Complicated128/CPE-301-Final-Project-Group-88/README.md

# Group 88's Final Project for CPE 301

This repository contains the code and all the reference materials that were used for assistance in the final project.

## Description

The final project is a physical swamp cooler. The swamp container contains these parts:

1. 3 Buttons (1 for start, stop, reset. 2 for stepper motor control)
2. Relays for Fan and Pump (2 SRD05VDC-SC-C)
3. Stepper Motor
4. LCD (LiquidCrystal Display)
5. Analog Water Sensor
6. DS1307 (External Clock)
7. DHT11 (Temperature Sensor)
8. ATMega2560
9. 12V 40CFM DC Blowerfan
10. Peristaltic Motor

## Circuit Details

<details>
<summary>3 Buttons (1 for start, stop, reset. 2 for stepper motor)</summary>
<br>
One button is used to control the entire circuit. It can start, stop, and reset.

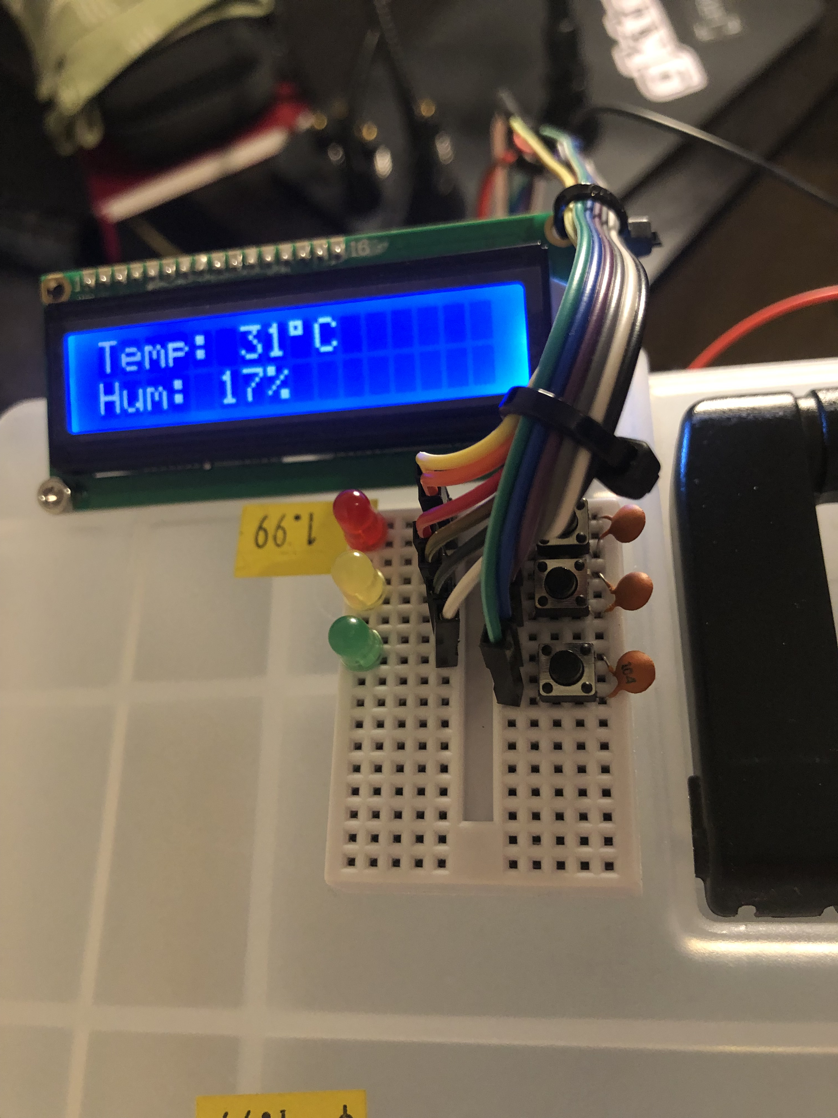
[picture p1: extras/circuitPhotos/wiring_IO.JPG]
image of circuit


The bottom button is used to control all of the states that it can (DISABLED, IDLE). The upper two buttons are stepper motor controls to turn either clockwise or counterclockwise.

</details>

<details>
<summary>Relays for Fan and Pump (2 SRD05VDC-SC-C)</summary>
<br>
We used relays to help simplify the control of fans and pumps. They are the red rectangles.

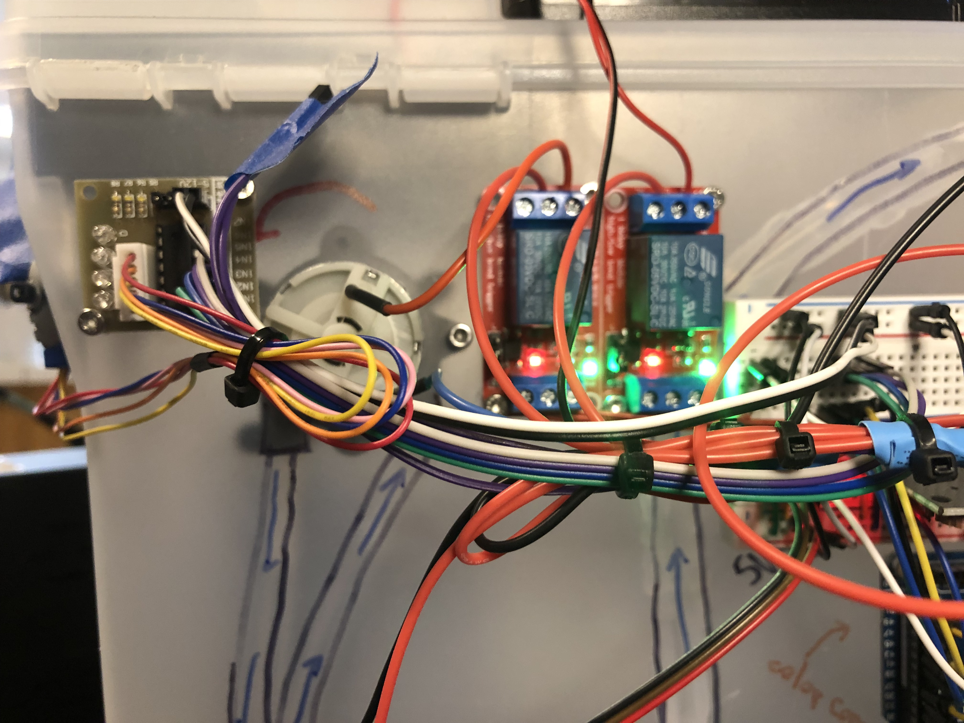
[picture p2: extras/circuitPhotos/wiring_control.JPG]
image of circuit


</details>

<details>
<summary>Stepper Motor</summary>
<br>
Stepper motor is used to adjust vent. It is to the left of the picture.

image of circuit

</details>

<details>
<summary>LCD (LiquidCrystal Display)</summary>
<br>
LCD is used to help display useful information. It is the big display.

image of circuit

</details>

<details>
<summary>Analog Water Sensor</summary>
<br>
It is used to measure how much water is inside the swamp cooler. It is on the bottom of the picture.

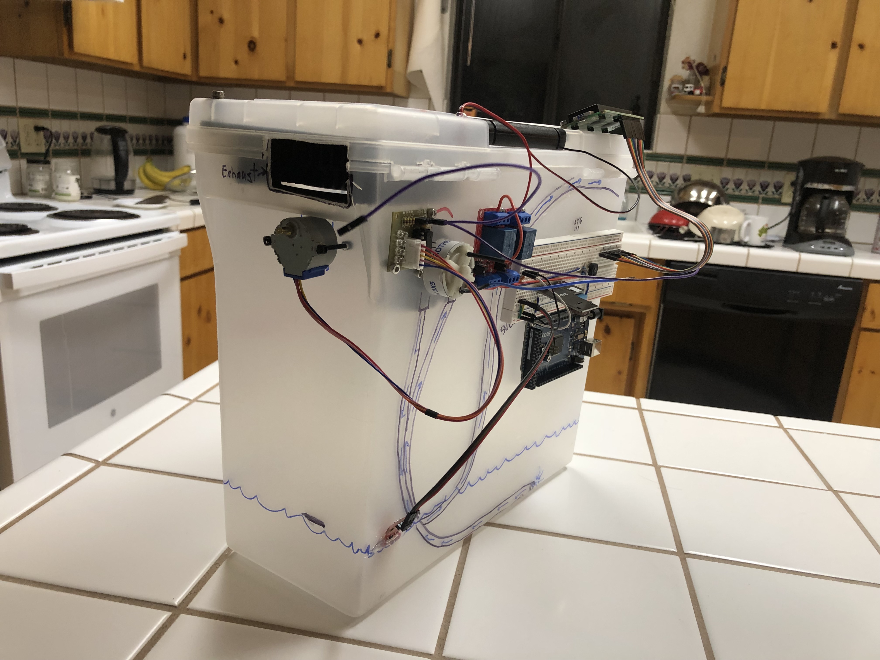
[picture p3: extras/buildPhotos/2_stepper_and_watersensor.JPG]


</details>

<details>
<summary>DS1307 (External Clock)</summary>
<br>
It is used to print accurate timestamps. It is in the middle of the white breadboard.

image of circuit


</details>

<details>
<summary>DS1307 (External Clock/RTC)</summary>
<br>
It is used to print accurate timestamps. It is in the middle of the white breadboard.

image of circuit

</details>

<details>
<summary>DHT11 (Temperature Sensor)</summary>
<br>
It is used to measure temperature and humidity. It is above the RTC.

image of circuit

</details>

<details>
<summary>ATMega2560</summary>
<br>
It is used to control the whole circuit. It is underneath the breadboard.

image of circuit

</details>

<details>
<summary>12V 40CFM DC Blowerfan</summary>
<br>
It is used to take in heat and dump it outside. It is the black thing with a rectangular shape.

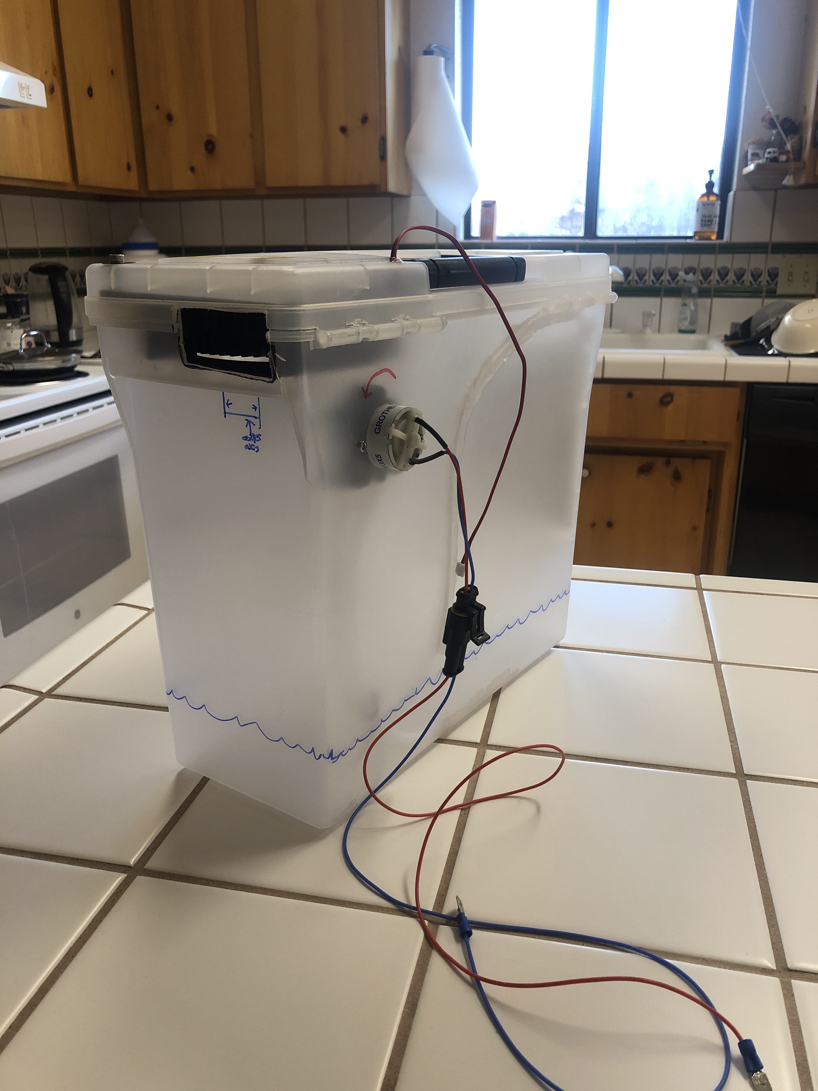
[picture p5: extras/buildPhotos/1_fanexhaust.jpg]


</details>

<details>
<summary>Peristaltic Motor</summary>
<br>
It is used to pump water to the cooler pad. It can be found underneat the Blowerfan.

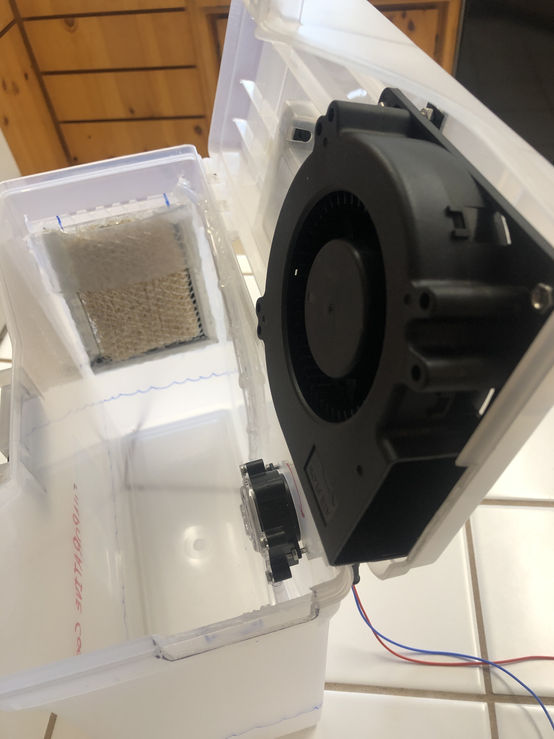
[picture p6: extras/buildPhotos/1_insideinprogress.jpg]


</details>

## Schematic Diagram

<details>
<summary>The diagram in question</summary>
<br>

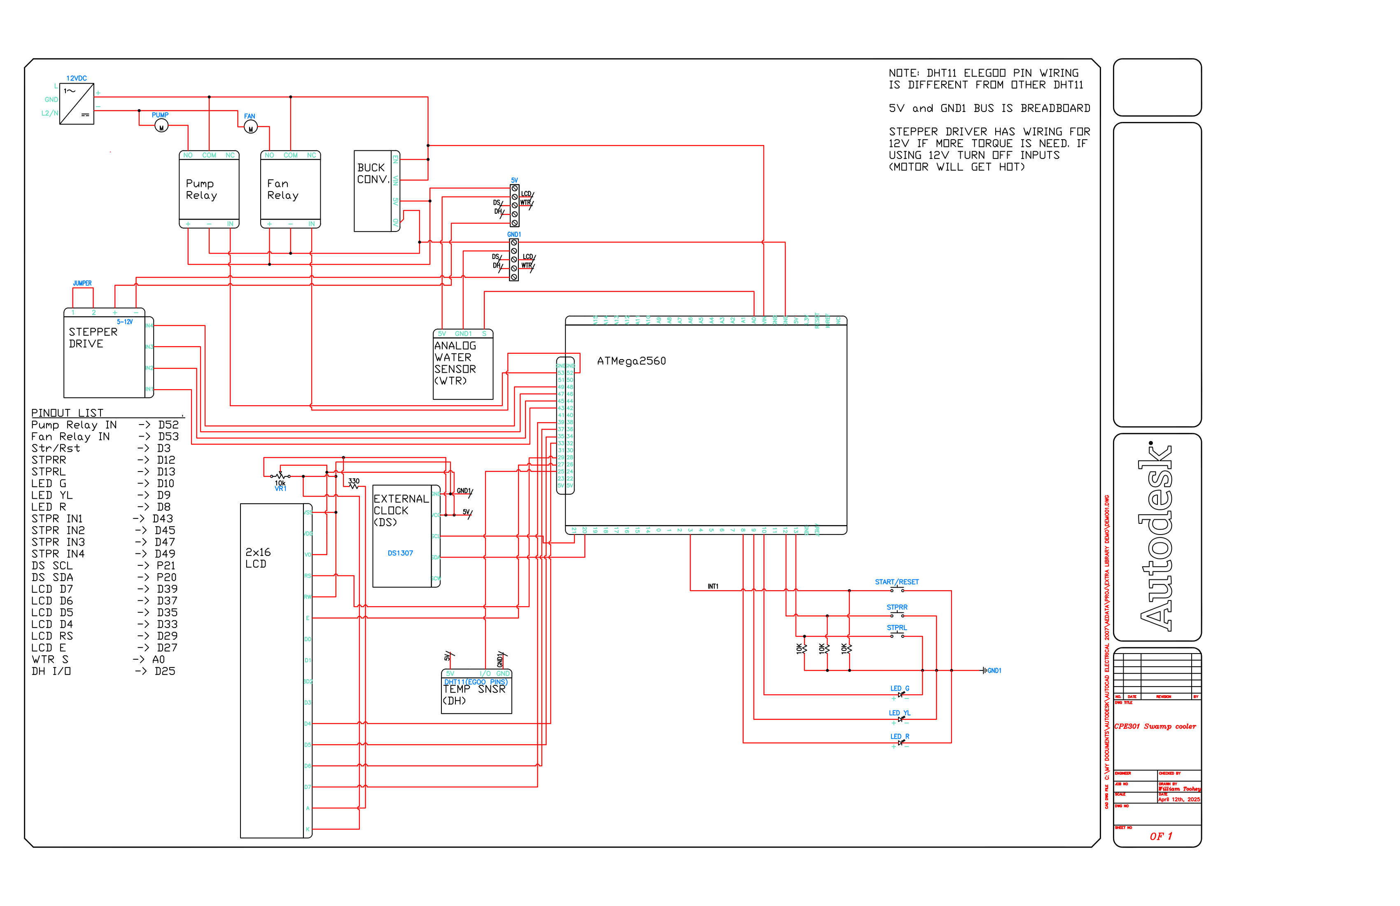
[picture p7: extras/cpe301finalwiringdiagram-1.png]


</details>

## System Demonstration

video of a swamp cooler project demonstration (https://www.youtube.com/watch?v=Vm3F59e2kbA)
Clicking upon this will redirect you to this link: https://www.youtube.com/watch?v=Vm3F59e2kbA

## Team Members
The team consists of the burnt out students: Aaron Ba, William Toohey, Sean Lai

All credit of the physical circuitry goes to William Toohey, along with some of the code. Aaron Ba and Sean Lai revamped the code.

## Extra Stuff

Check out the "extras" folder as it has many more photos of the circuit, and the physical build.

It also includes the final report(s) and the wiring diagram. 

### Deviations from the given diagrams
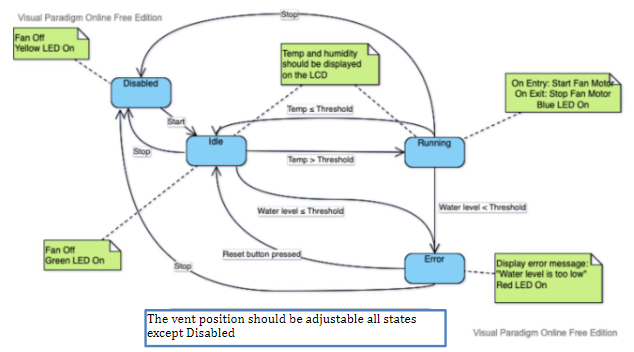
[picture p8: extras/imageOrig.png]


versus

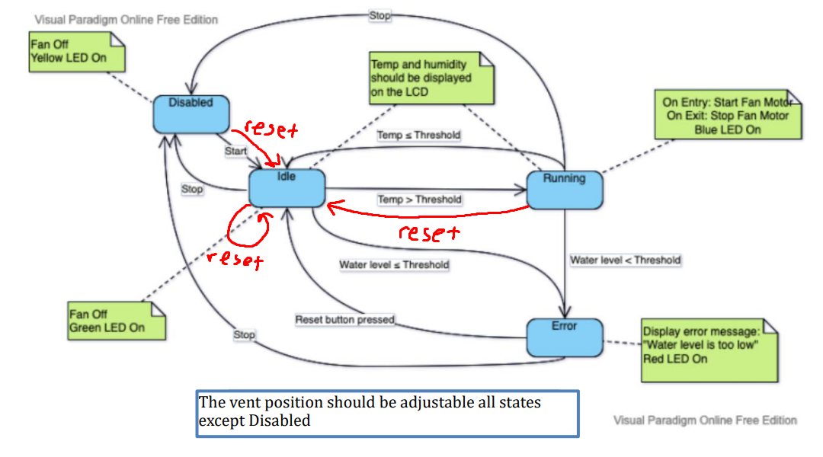
[picture p9: extras/imageReset.png]


To us, this makes more sense because why would reset only work for ERROR?
We made it so that everytime we hold the button (holding triggers reset), it will do the setup again and pretend it started at the very beginning.
