Complicated128/CPE-301-Final-Project-Group-88/extras/CPE301Final Report.pdf

# CPE301 Group 88: Swamp Cooler

CPE 301 Embedded System Design - University of Nevada, Reno

## 1. Project Description

This project implements an evaporative cooling system (swamp cooler) using the ATmega2560 microcontroller. The project consists of all the components found in teSystem monitors temperature and humidity levels, controls a fan motor based on temperature thresholds, monitors water levels, provides user controls for system operation and vent adjustment, and logs state transitions to a host computer. The implementation uses register-level programming for most functionality, avoiding high-level Arduino functions like pinMode() and digitalWrite() as specified in the requirements.

## 2. Component Details

Microcontroller

- ATmega2560: The primary controller.

Sensors

- DHT11 Temperature and Humidity Sensor: Connected to the microcontroller to monitor ambient temperature and humidity.The sensor values are read through pins SCL and SDA using serial communications, with data displayed on the LCD during the RUNNING or IDLE state.
- Water Level Sensor: Used to monitor the reservoir water level. Implemented using direct ADC sampling without the Arduino ADC library. When water levels fall below threshold, the system enters the ERROR state, this ERROR state must then be clear and the sensor value will be reread to determine the machine state.

Actuators

- GPU Fan: Repurposed for primary air circulation it provides ~40cfm at 12VDC, controlled by a separate power supply board to prevent damage to the Arduino and controlled using a SRD-05VDC relay breakout board with optocouplers, flyback diodes and transistors. The fan logic is determined by temperature readings and the current state through direct register manipulation.
- Stepper Motor: Used to simulate the use of a vent to directionally control the airflow or restrict airflow out of the exhaust. The vent is adjusted using push buttons on the top of the cooler adjustable by the user through a potentiometer. The Arduino stepper library was used to position the stepper motor.
- Peristaltic Pump: 12V peristaltic pump with .25” vinyl tubing to circulate water through the system. The pump is controlled using a SRD-05VDC relay breakout board with optocouplers, flyback diodes, and transistors.

User Interface

- LCD Display: Shows current temperature, humidity, during the IDLE or RUNNING state.
- LEDs: Indicate system status:
- Yellow LED: Indicates DISABLED state
- Green LED: Indicates IDLE state
- Blue LED: Indicates RUNNING state
- Red LED: Indicates ERROR state
- Control Button: Performs 3 distinct operations depending on system state using ISR()
- DISABLED -> IDLE if no errors exist.
- RUNNING -> DISABLED turns off fan and pump.
- ERROR -> IDLE/RUNNING user must hold button for 3 seconds to clear error.

Additional Components

- Peristaltic Pump: Circulates water through the system
- Relays: Control power to the fan and water pump.
- Evaporative Cooling Pads: Provide the wet surface for air evaporation cooling.
- File Cabinet Box: Housing.
- 12V GPU Blower Fan: Circulate air through the housing.
- Capacitors: Various capacitor values were implemented to eliminate the need for debouncing logic in the code. Also used to damped initial voltage drop that may be seen from the power supply to the buck converter when transition to RUNNING state.
- 19V->5V 2A Buck Converter: Converter to step down a regulated voltage from 12VDC to 5VDC.

## 3. System Overview

Swamp cooler operates as a finite state machine with four states:

1. DISABLED State:
- Yellow LED on
- No temperature or water level monitoring
- System responds only to the Start button (via ISR)
- Vent control disabled
2. IDLE State:
- Green LED on
- Continuous temperature, humidity, and water level monitoring

- Fan off
- Transitions to RUNNING when temperature exceeds threshold
- Transitions to ERROR if water level is too low
- Transitions to DISABLED if Stop button pressed
- Vent position adjustable
3. RUNNING State:
- Blue LED on
- Fan motor on
- Continuous monitoring of temperature, humidity, and water level
- Transitions to IDLE when temperature falls below threshold
- Transitions to ERROR if water level is too low
- Transitions to DISABLED if Stop button pressed
- Vent position adjustable
4. ERROR State:
- Red LED on
- Fan motor off
- Error message displayed on LCD ("Water level is too low")
- Transitions to IDLE if Reset button held for 3 seconds and water level is sufficient

The system operates within the following constraints:

- 12V 1.5A (21V 2A MAX)

## 4. Circuit Image

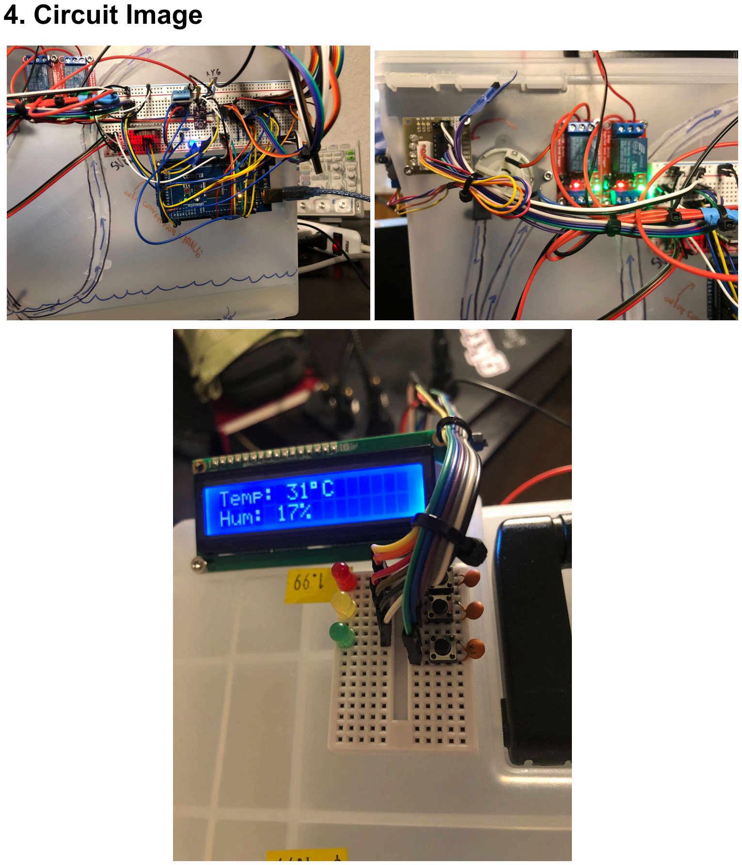
[picture p10: page 4]

## 5. Schematic Diagram

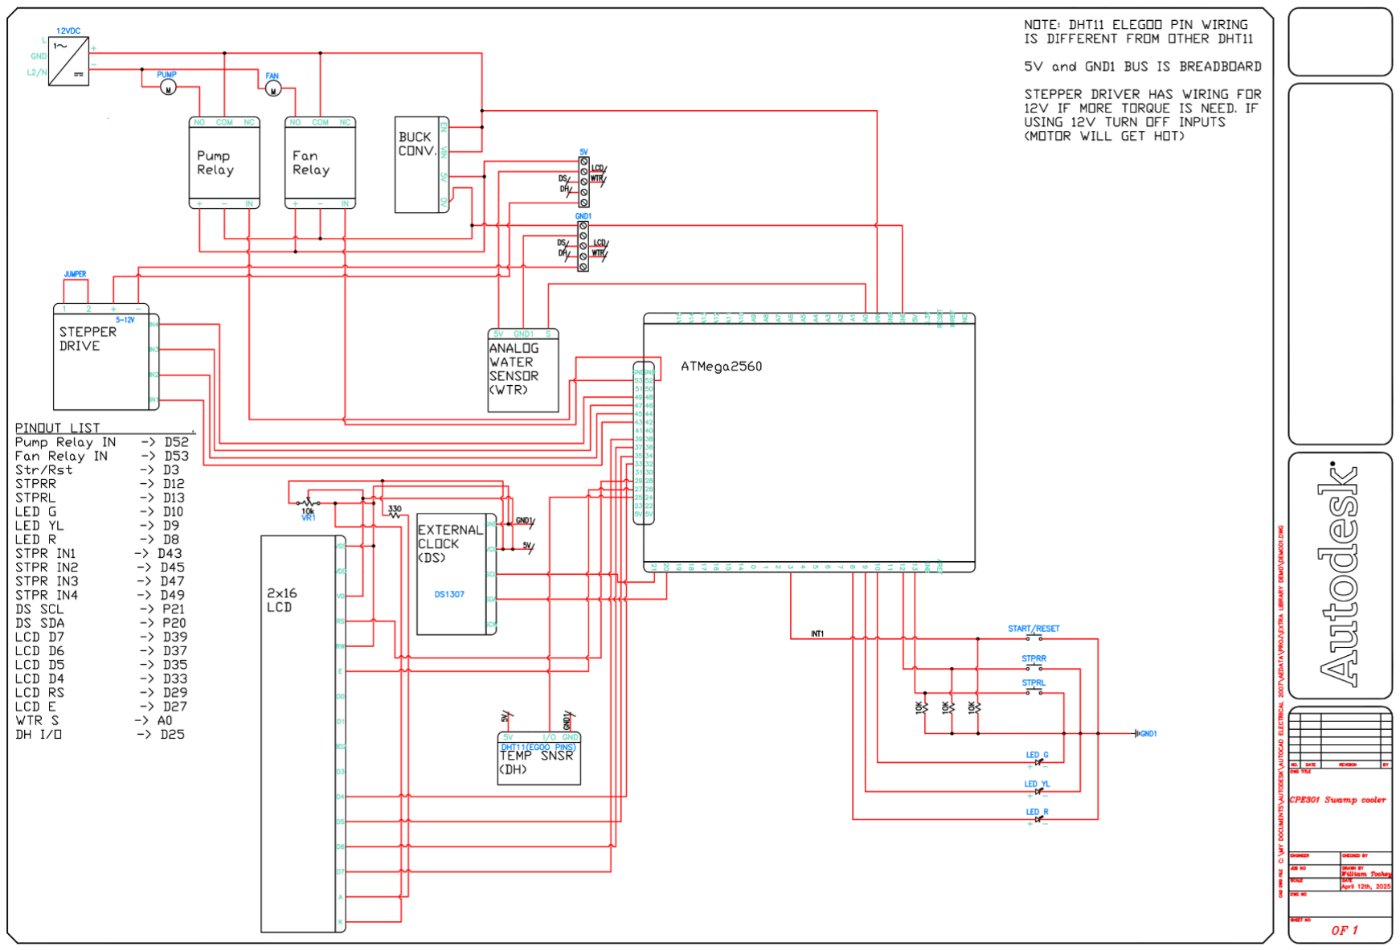
[picture p11: figure]

## 6. Demonstration

https://www.youtube.com/watch?v=Vm3F59e2kbA

## 7. Links

https://github.com/Complicated128/CPE-301-Final-Project-Group-88/blob/main/README.md
