Complicated128/CPE-301-Final-Project-Group-88/extras/buildPhotos/2_main_component_mounts.JPG

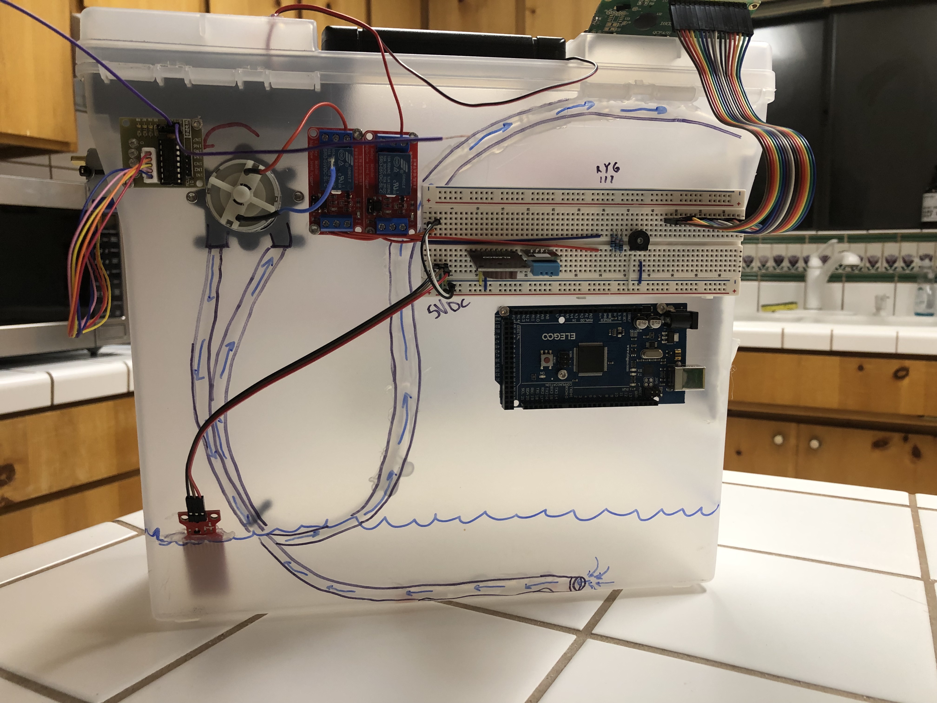
extras/buildPhotos/2_main_component_mounts.JPG
