Complicated128/CPE-301-Final-Project-Group-88/extras/buildPhotos/1_coolerpadtrough.jpg

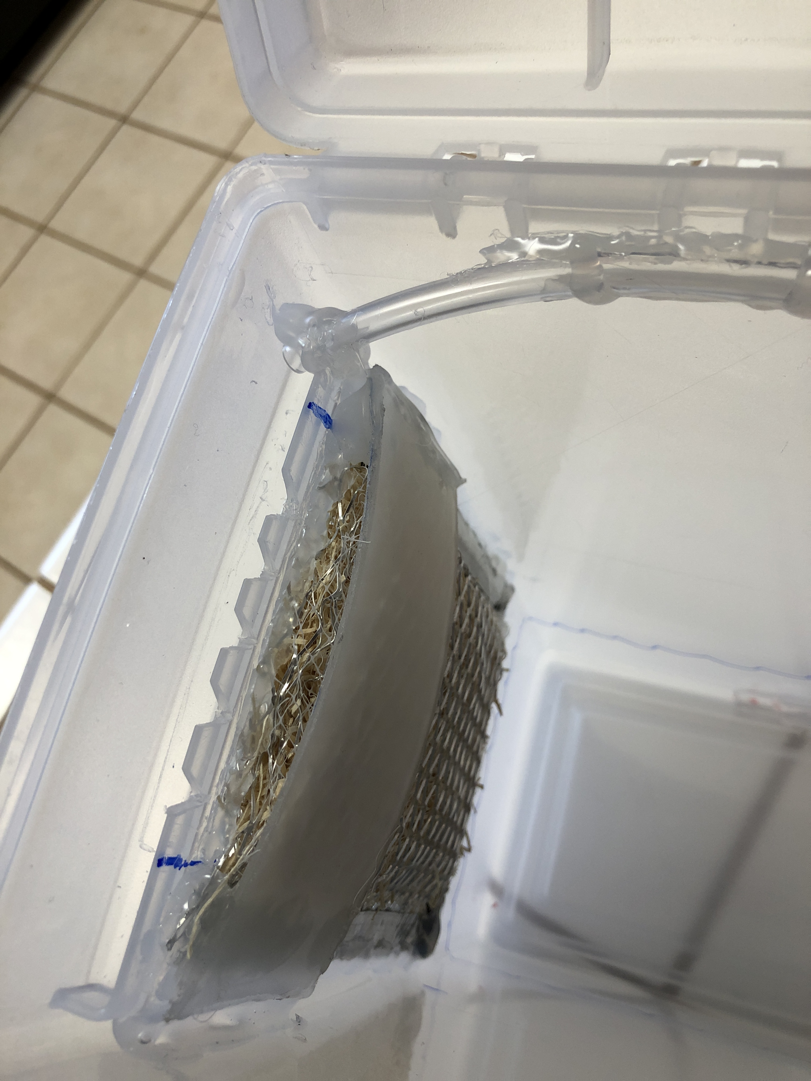
extras/buildPhotos/1_coolerpadtrough.jpg
