Complicated128/CPE-301-Final-Project-Group-88/extras/buildPhotos/2_lcdmount.JPG

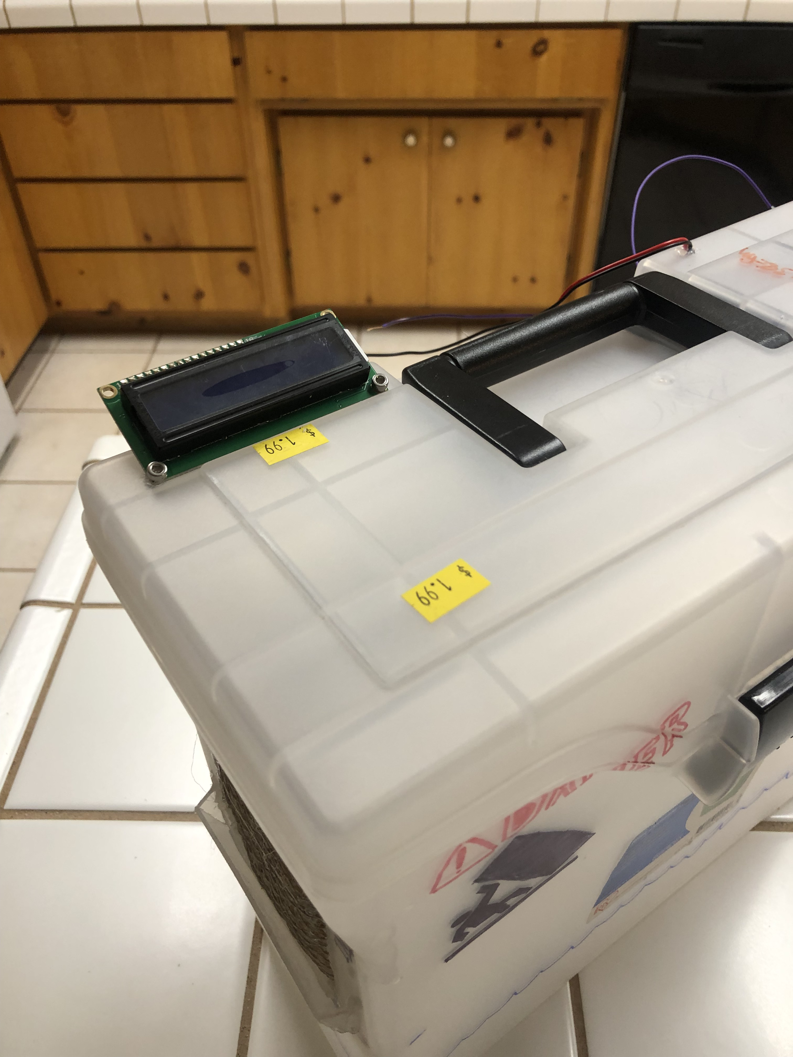
extras/buildPhotos/2_lcdmount.JPG
