Complicated128/CPE-301-Final-Project-Group-88/extras/buildPhotos/3_wiring.JPG

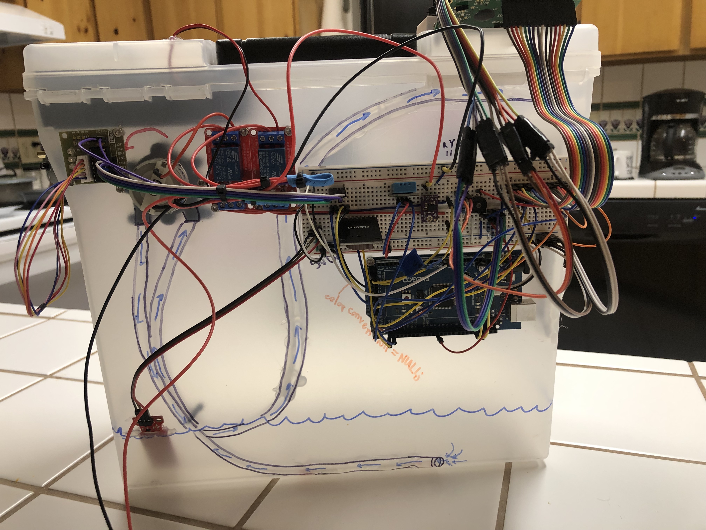
extras/buildPhotos/3_wiring.JPG
