Complicated128/CPE-301-Final-Project-Group-88/extras/buildPhotos/running.JPG

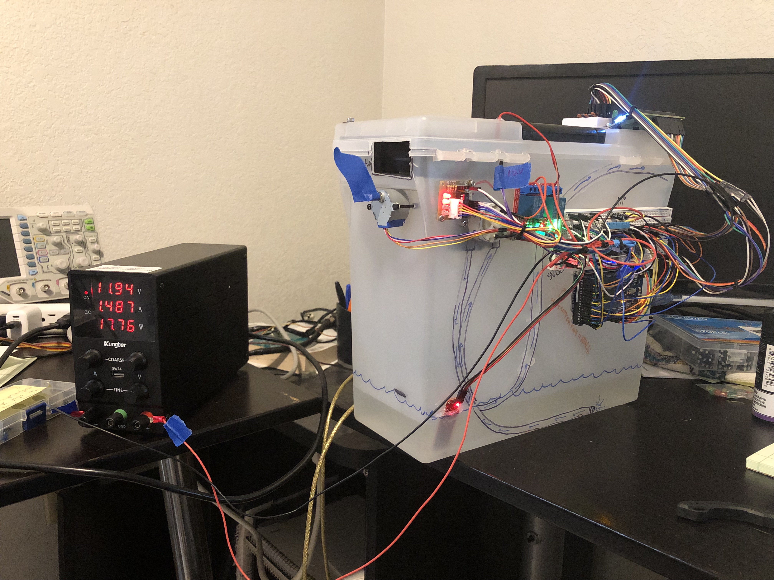
extras/buildPhotos/running.JPG
