Complicated128/CPE-301-Final-Project-Group-88/extras/buildPhotos/running_face.JPG

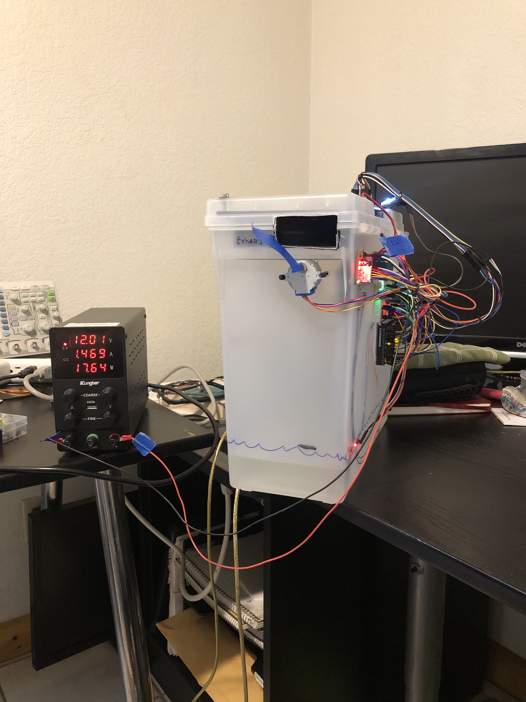
extras/buildPhotos/running_face.JPG
