Complicated128/CPE-301-Final-Project-Group-88/extras/buildPhotos/runningtemps.JPG

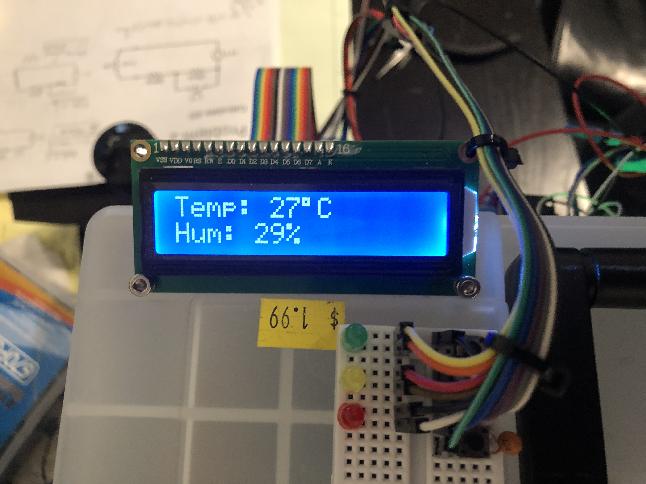
extras/buildPhotos/runningtemps.JPG
