Complicated128/CPE-301-Final-Project-Group-88/extras/buildPhotos/stepperboardbroken.JPG

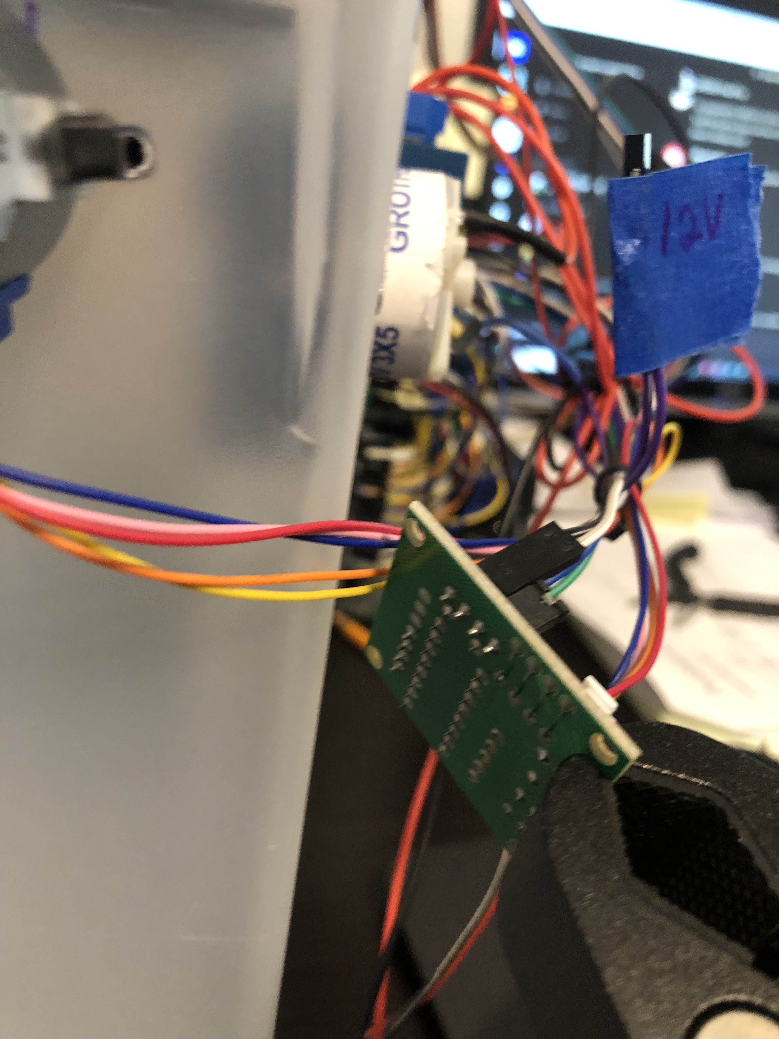
extras/buildPhotos/stepperboardbroken.JPG
