Complicated128/CPE-301-Final-Project-Group-88/extras/buildPhotos/steppermotorsupply.JPG

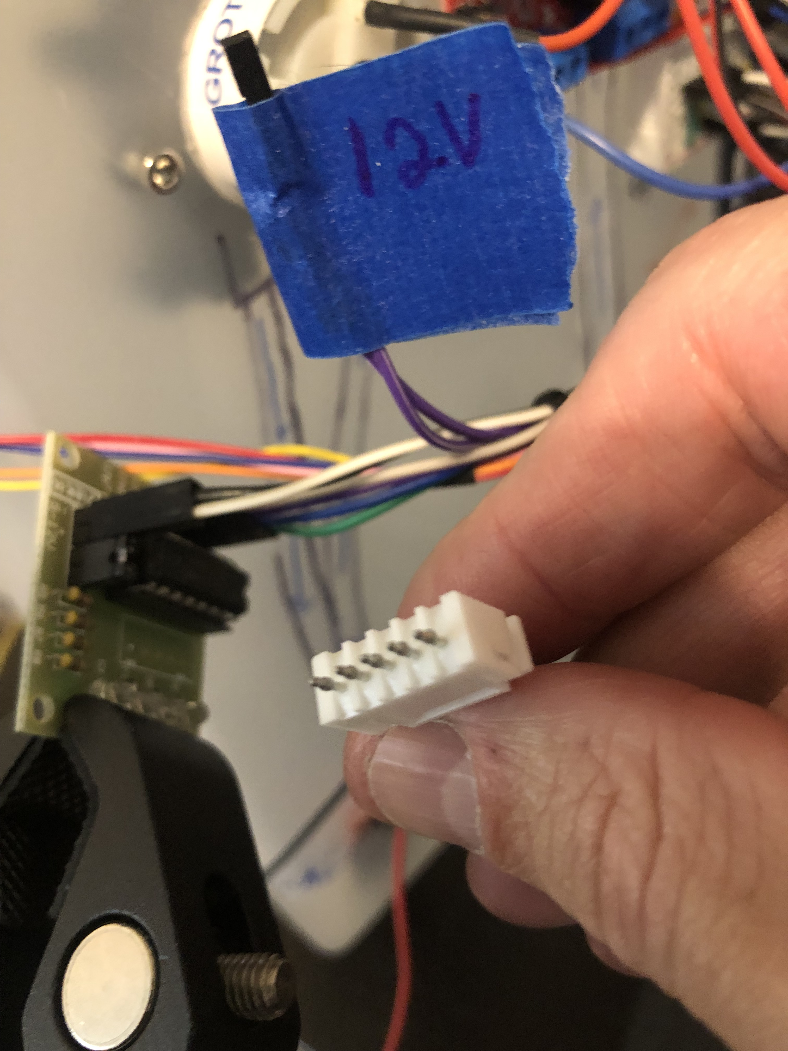
extras/buildPhotos/steppermotorsupply.JPG
