Complicated128/CPE-301-Final-Project-Group-88/extras/buildPhotos/stepperresoldered.JPG

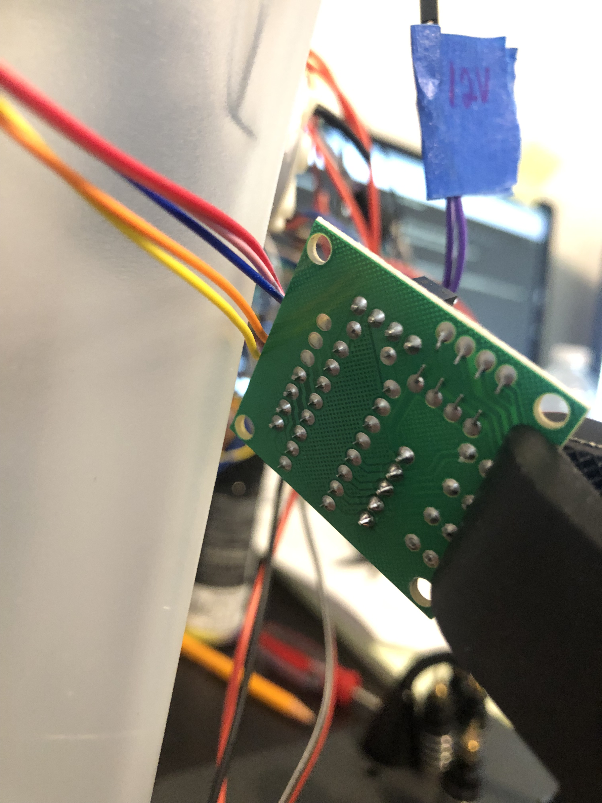
extras/buildPhotos/stepperresoldered.JPG
