Complicated128/CPE-301-Final-Project-Group-88/extras/buildPhotos/tempambientdesk.jpg

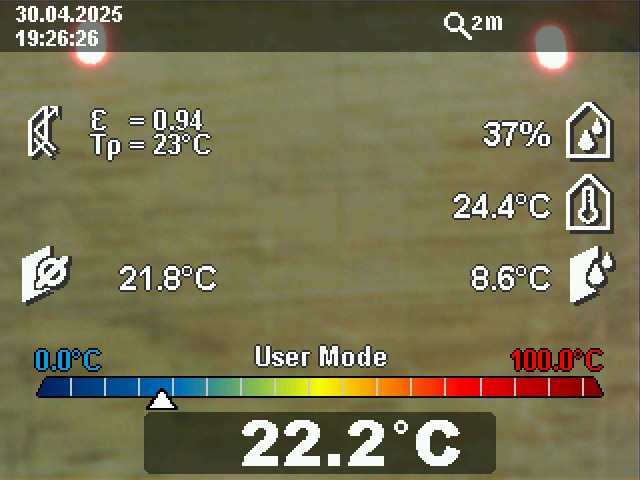
extras/buildPhotos/tempambientdesk.jpg
