Complicated128/CPE-301-Final-Project-Group-88/extras/buildPhotos/tempcontainer.jpg

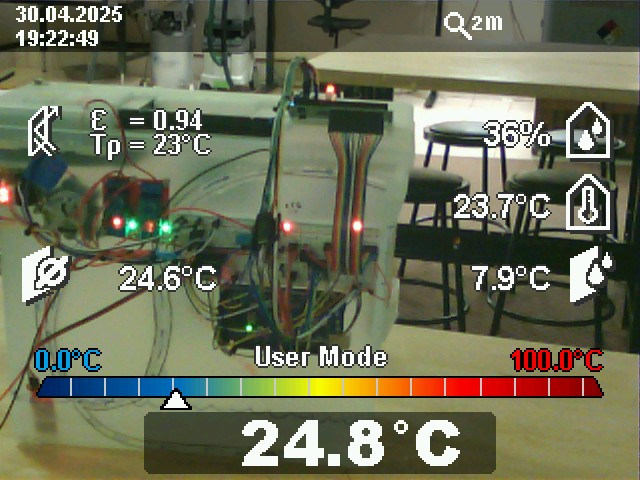
extras/buildPhotos/tempcontainer.jpg
