Complicated128/CPE-301-Final-Project-Group-88/extras/buildPhotos/tempexhaust.jpg

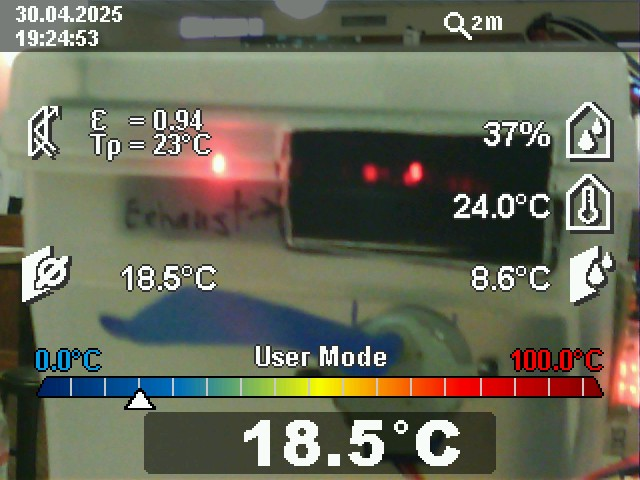
extras/buildPhotos/tempexhaust.jpg
