Complicated128/CPE-301-Final-Project-Group-88/extras/buildPhotos/tempintake.jpg

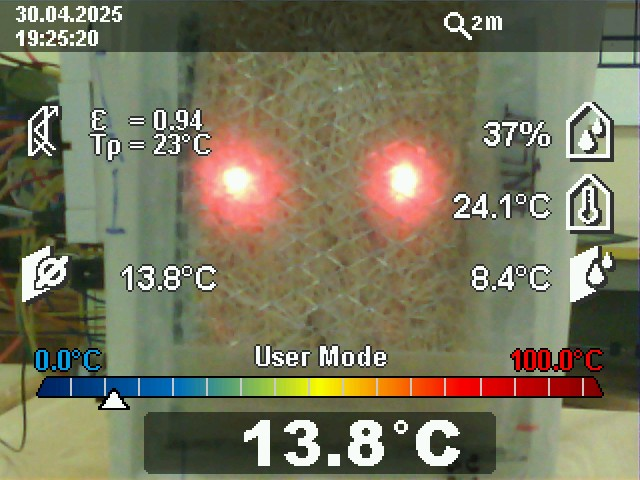
extras/buildPhotos/tempintake.jpg
