Complicated128/CPE-301-Final-Project-Group-88/extras/cpe301finalwiringdiagram.pdf

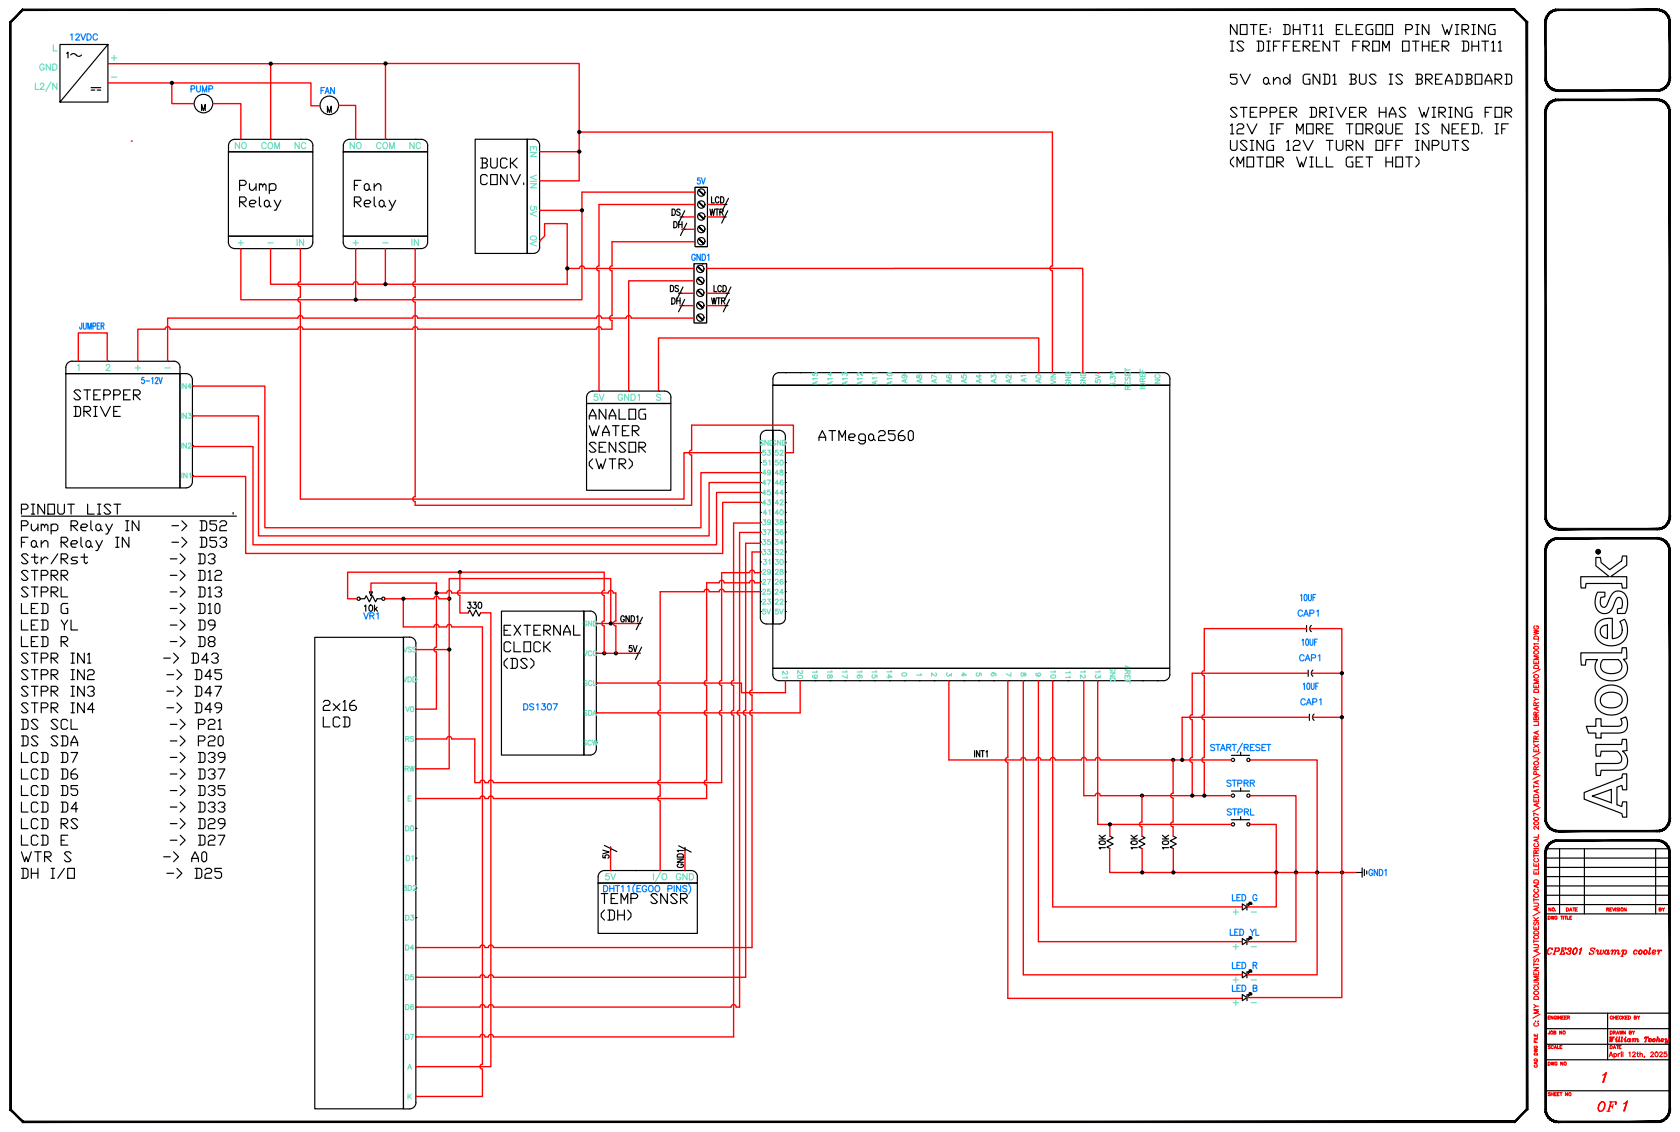
[picture p27: page 1]
