Complicated128/CPE-301-Final-Project-Group-88/(commit log)

2025-05-07 added print message
2025-05-07 added adc functionality
2025-05-08 finished UART functions and started formatting
2025-05-08 Add files via upload
    Wiring diagram with blue led and capacitors added
2025-05-09 start stepper buuttons
2025-05-09 Completed stepper buttons
2025-05-09 fixed LOW logics and maybe made display refresh every minute?
    [main.cpp, timer_example-3.ino]
2025-05-10 fix double click issue
    [main.cpp]
2025-05-10 prettied up output, removed unused funcs, redid ERROR msg logic, made timer delay function
    [main.cpp]
2025-05-10 forgot buttonpress
2025-05-10 changing interrupt to CHANGE
2025-05-10 Create CircuitPhotos
2025-05-10 change print method
