Complicated128/CPE-301-Final-Project-Group-88/extras/buildPhotos/wiring_logic.JPG

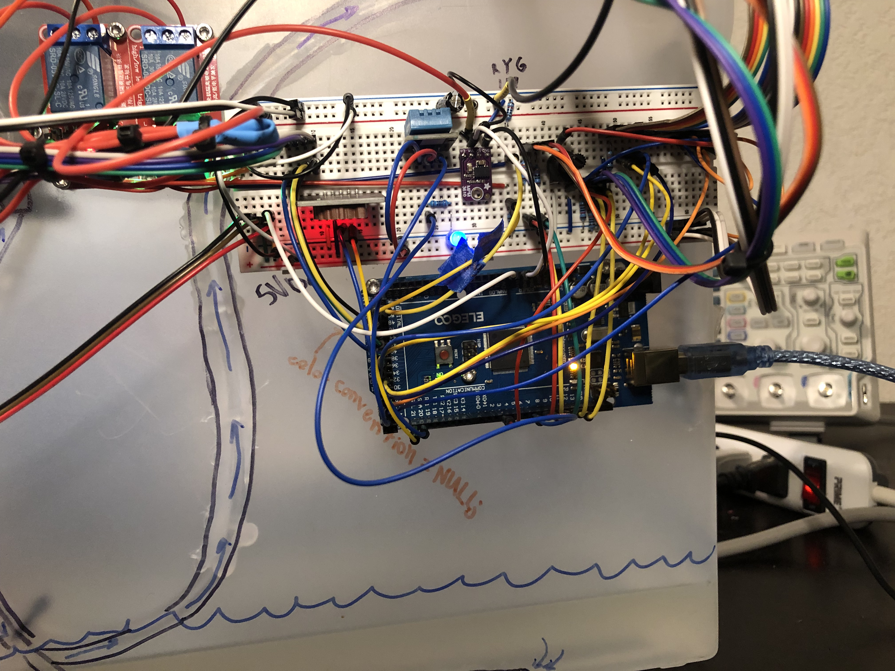
[picture p4: extras/circuitPhotos/wiring_logic.JPG]
extras/buildPhotos/wiring_logic.JPG
